DIEHARDave/LaneTag/docs/logo/3d/lanetag-logo-stacked-dark.obj

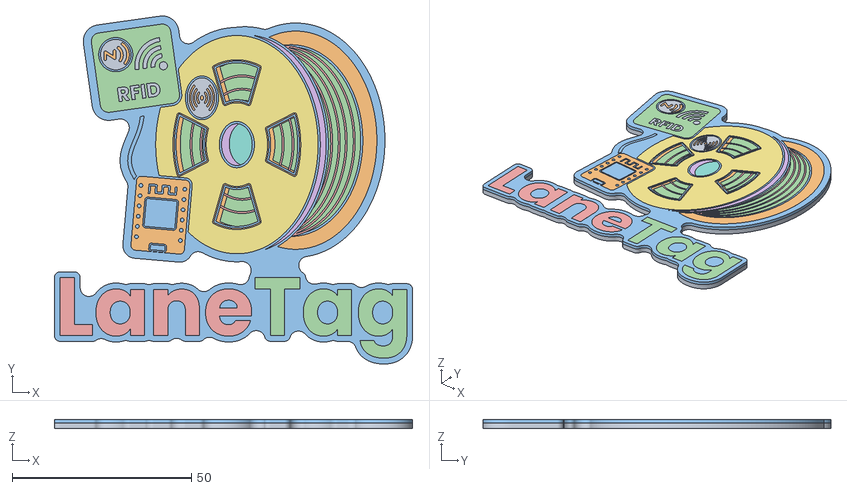
[picture p10: CAD file, 2026-11-13]
docs/logo/3d/lanetag-logo-stacked-dark.obj
100.0 x 97.1 x 2.60
base_plate
color_243241
color_1b2632
color_f28a1e
color_c9650f
color_53697f
color_3a4e63
color_141c25
color_ffffff
color_1e88e5
color_c8d0d8
color_d93a2f
color_eef2f6
