DIEHARDave/LaneTag/docs/logo/print/inlay-facedown/lanetag-icon-orange.stl

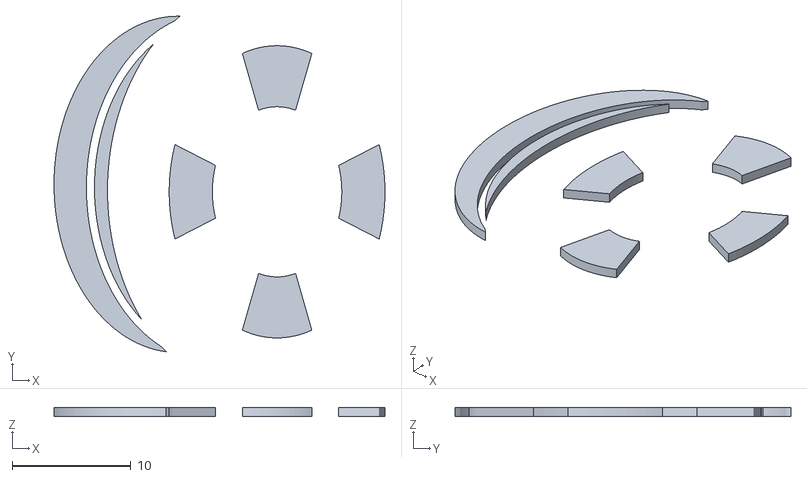
[picture p11: CAD file, 2026-11-13]
docs/logo/print/inlay-facedown/lanetag-icon-orange.stl
27.9 x 28.3 x 0.8
