DIEHARDave/LaneTag/docs/logo/print/inlay/lanetag-icon-white.stl

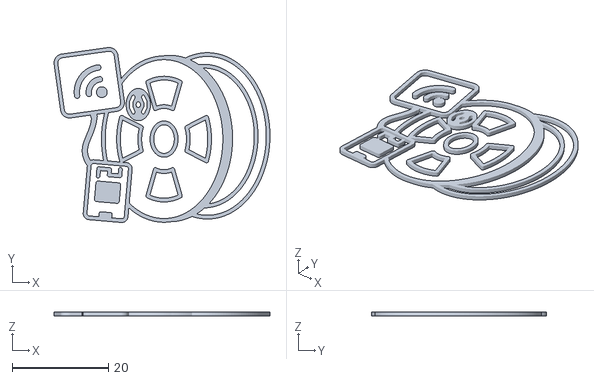
[picture p12: CAD file, 2026-11-13]
docs/logo/print/inlay/lanetag-icon-white.stl
45.0 x 36.5 x 0.8
