DIEHARDave/LaneTag/docs/logo/print/lanetag-logo-4color-B.obj

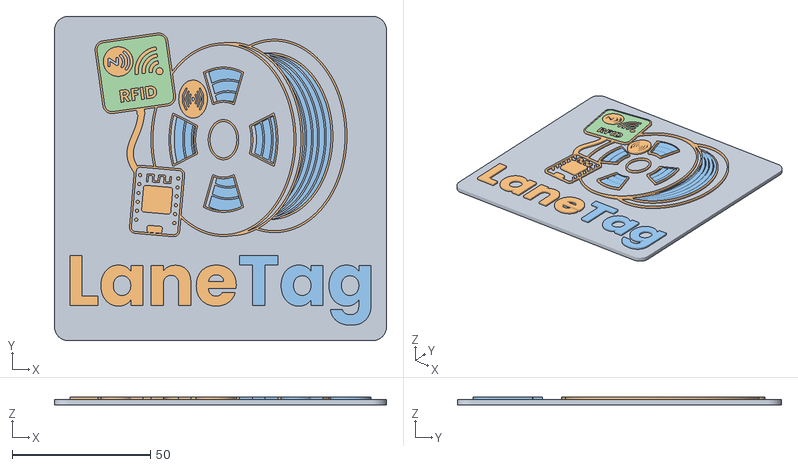
[picture p13: CAD file, 2026-11-13]
docs/logo/print/lanetag-logo-4color-B.obj
120.0 x 117.2 x 3.00
Plate_Black
Top_White
Top_Orange
Top_Red
