DIEHARDave/LaneTag/docs/logo/print/inlay-facedown/lanetag-text-white.stl

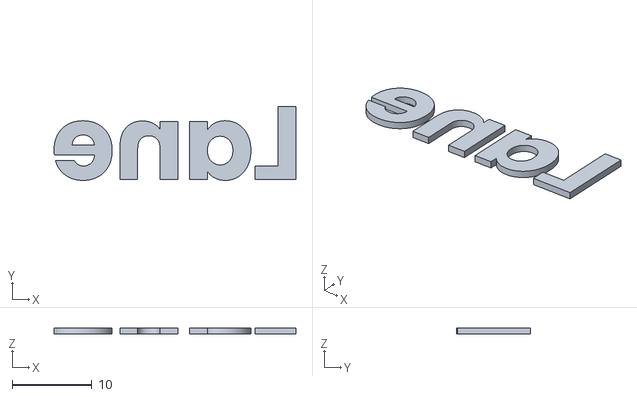
[picture p14: CAD file, 2026-11-13]
docs/logo/print/inlay-facedown/lanetag-text-white.stl
30.4 x 9.27 x 0.8
