DIEHARDave/LaneTag/docs/logo/print/lanetag-text-inlay-facedown.obj

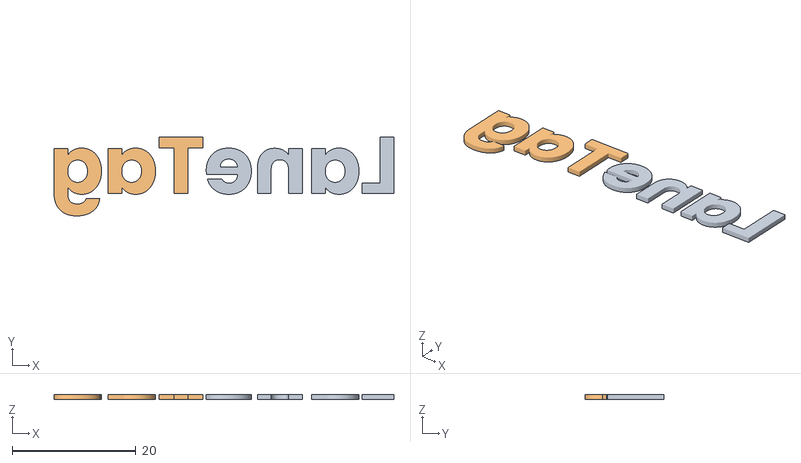
[picture p15: CAD file, 2026-11-13]
docs/logo/print/lanetag-text-inlay-facedown.obj
55.0 x 12.8 x 0.8
TextFD_White
TextFD_Orange
