DIEHARDave/LaneTag/docs/logo/print/inlay-facedown/lanetag-icon-red.stl

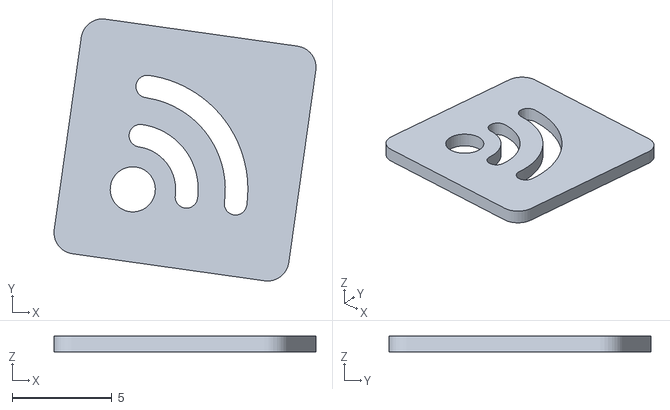
[picture p16: CAD file, 2026-11-13]
docs/logo/print/inlay-facedown/lanetag-icon-red.stl
13.1 x 13.1 x 0.8
