DIEHARDave/LaneTag/docs/logo/print/lanetag-icon-inlay-facedown.obj

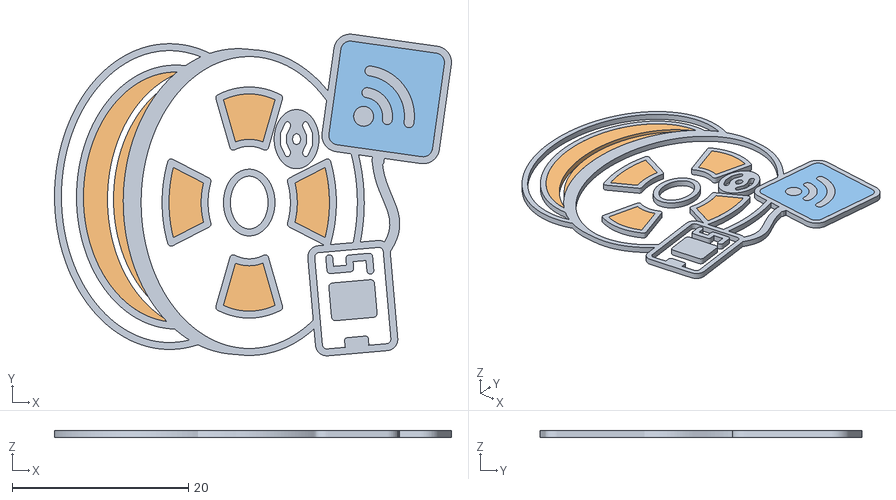
[picture p17: CAD file, 2026-11-13]
docs/logo/print/lanetag-icon-inlay-facedown.obj
45.0 x 36.5 x 0.8
IconFD_White
IconFD_Orange
IconFD_Red
