DIEHARDave/LaneTag/docs/logo/print/inlay/lanetag-text-orange.stl

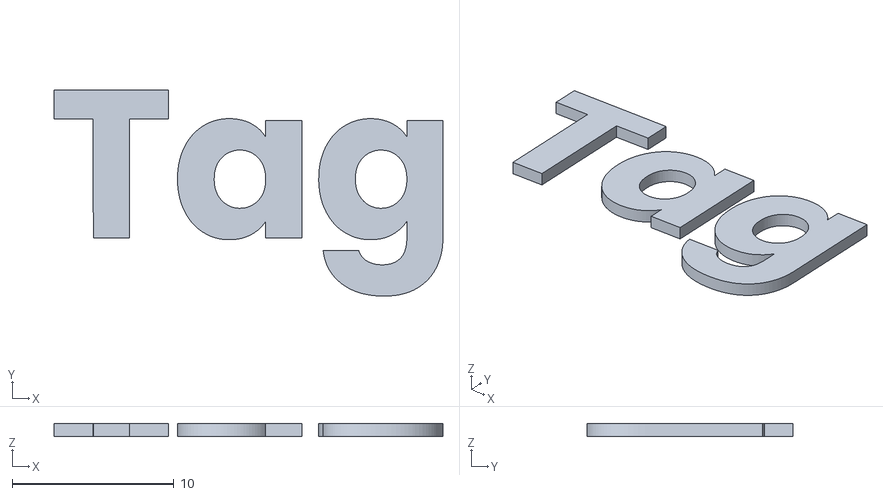
[picture p18: CAD file, 2026-11-13]
docs/logo/print/inlay/lanetag-text-orange.stl
24.1 x 12.8 x 0.8
