DIEHARDave/LaneTag/(list of files, cad)

Other CAD files:
docs/logo/print/inlay/lanetag-text-white.stl
docs/logo/print/inlay/lanetag-icon-orange.stl
docs/logo/print/inlay-facedown/lanetag-icon-white.stl
docs/logo/print/lanetag-icon-inlay.obj
docs/logo/print/inlay-facedown/lanetag-text-orange.stl
docs/logo/print/inlay/lanetag-icon-red.stl
docs/logo/print/lanetag-text-inlay.obj
docs/logo/3d/lanetag-logo-stacked-dark.blend
docs/logo/print/lanetag-inlays.blend
docs/logo/print/lanetag-logo-4color-B.blend
