DIEHARDave/LaneTag/src/display.cpp

#include "display.h"

#include <U8g2lib.h>
#include <WiFi.h>
#include <Wire.h>
#include <driver/gpio.h>
#include <esp_sleep.h>
#include <soc/soc_caps.h>

#include "app.h"
#include "lcd1602.h"
#include "tft.h"
#include "version.h"

namespace {

// The bus the display is on: Wire when it shares the PN532's pins (or the
// reader is not on I2C), else Wire1.
TwoWire *bus = nullptr;

// A scan stays on the screen this long (unless it waits for a slot).
constexpr uint32_t SCAN_SHOWN = 5 * 60 * 1000;
constexpr uint32_t SLOT_SHOWN = 3000;
constexpr uint32_t SPLASH_SHOWN = 3000;
constexpr uint32_t DRAW_INTERVAL = 200;
constexpr int WIDTH = 128;
// A title too long even in the smallest font scrolls: still for a moment,
// then two pixels per frame, round with a gap. Only the top 16 rows (two
// tile rows, 256 bytes) are sent for it.
constexpr uint32_t SCROLL_PAUSE = 2000, SCROLL_FRAME = 100;
constexpr int SCROLL_STEP = 2, SCROLL_GAP = 24, TITLE_BYTES = 256;
// On the LCD a row too long for it scrolls a character at a time.
constexpr uint32_t LCD_SCROLL_STEP = 350;
constexpr int LCD_SCROLL_GAP = 3;

const uint8_t *const SMALL = u8g2_font_5x7_tf;
const uint8_t *const MEDIUM = u8g2_font_6x10_tf;
const uint8_t *const LARGE = u8g2_font_helvB12_tf;
const uint8_t *const TITLE_SMALLER = u8g2_font_helvB10_tf;
const uint8_t *const HUGE_ = u8g2_font_helvB24_tf;
// Sized so the spool, "Lane" and the "Tag" box fit the 128 px OLED.
const uint8_t *const WORDMARK = u8g2_font_helvB14_tr;

// A spool side on, for the LCD's start-up screen: two flanges and the
// filament between them.
const uint8_t LCD_SPOOL[8] = {0b11111, 0b01110, 0b01110, 0b01110, 0b01110, 0b01110, 0b11111, 0b00000};

// The release part of the version: "v0.2.0-2" for "v0.2.0-2-g2d9f574-dirty".
String shortVersion() {
    String v = FIRMWARE_VERSION;
    int g = v.indexOf("-g");
    return g > 0 ? v.substring(0, g) : v;
}

uint8_t byteCallback(u8x8_t *u8x8, uint8_t msg, uint8_t count, void *data) {
    switch (msg) {
    case U8X8_MSG_BYTE_SEND: bus->write((uint8_t *)data, count); break;
    case U8X8_MSG_BYTE_START_TRANSFER: bus->beginTransmission(u8x8_GetI2CAddress(u8x8) >> 1); break;
    case U8X8_MSG_BYTE_END_TRANSFER: bus->endTransmission(); break;
    case U8X8_MSG_BYTE_INIT:
    case U8X8_MSG_BYTE_SET_DC: break;
    default: return 0;
    }
    return 1;
}

// The 16 characters of an LCD row shown now: the text itself when it fits,
// else a window scrolling round it (after a pause at the start).
String lcdFrame(const String &text, uint32_t since) {
    if ((int)text.length() <= Lcd1602::COLS) return text;
    String round = text + String("   ").substring(0, LCD_SCROLL_GAP);
    uint32_t span = round.length();
    uint32_t t = (millis() - since) % (SCROLL_PAUSE + span * LCD_SCROLL_STEP);
    int offset = t < SCROLL_PAUSE ? 0 : (t - SCROLL_PAUSE) / LCD_SCROLL_STEP;
    return (round + text).substring(offset, offset + Lcd1602::COLS);
}

// Left and right in one LCD row, the left cut to make room.
String lcdSplit(String left, const String &right) {
    int room = Lcd1602::COLS - right.length() - 1;
    if (room < 1) return right;
    if ((int)left.length() > room) left.remove(room);
    while ((int)left.length() < room + 1) left += ' ';
    return left + right;
}

struct NamedColor { const char *name; uint32_t rgb; };
const NamedColor COLOR_NAMES[] = {
    {"white", 0xFFFFFF}, {"black", 0x000000}, {"grey", 0x808080}, {"light grey", 0xC0C0C0},
    {"dark grey", 0x404040}, {"red", 0xE02020}, {"dark red", 0x801010}, {"orange", 0xFF8000},
    {"yellow", 0xFFE020}, {"gold", 0xC8A040}, {"beige", 0xE8D8B0}, {"brown", 0x804820},
    {"green", 0x20B040}, {"lime", 0xA0E040}, {"dark green", 0x105828}, {"teal", 0x109090},
    {"cyan", 0x40D8F0}, {"light blue", 0x80B8F0}, {"blue", 0x2050E0}, {"navy", 0x182868},
    {"purple", 0x7030B0}, {"violet", 0xB060F0}, {"magenta", 0xF030C0}, {"pink", 0xF8A0C0},
};

}  // namespace

// The nearest by the "redmean" distance.
const char *colorName(uint32_t color) {
    long r1 = (color >> 16) & 0xFF, g1 = (color >> 8) & 0xFF, b1 = color & 0xFF;
    const char *best = "";
    double bestDistance = 1e18;
    for (auto &c : COLOR_NAMES) {
        long r2 = (c.rgb >> 16) & 0xFF, g2 = (c.rgb >> 8) & 0xFF, b2 = c.rgb & 0xFF;
        double mean = (r1 + r2) / 2.0;
        double d = (2 + mean / 256) * (r1 - r2) * (r1 - r2) + 4 * (g1 - g2) * (g1 - g2) +
                   (2 + (255 - mean) / 256) * (b1 - b2) * (b1 - b2);
        if (d < bestDistance) {
            bestDistance = d;
            best = c.name;
        }
    }
    return best;
}

const char *displayTypeName(DisplayType type) {
    switch (type) {
    case DisplayType::SSD1306: return "ssd1306";
    case DisplayType::SH1106: return "sh1106";
    case DisplayType::CydIli9341: return "cyd";
    case DisplayType::CydSt7789: return "cyd-st7789";
    case DisplayType::C6Lcd147: return "c6-lcd147";
    case DisplayType::Lcd19: return "lcd19";
    case DisplayType::Lcd114: return "lcd114";
    case DisplayType::Lcd169: return "c6-lcd169";
    case DisplayType::Lcd1602: return "lcd1602";
    default: return "none";
    }
}

void Display::begin(const DisplayConfig &config, const ReaderPins &reader) {
    if (config.type == DisplayType::None) return;
    if (isTft(config.type)) {
#ifdef HAS_TFT
        tft_ = new Tft();
        tft_->begin(config);
#else
        error_ = "this firmware has no touch screen support";
#endif
        return;
    }
    if (config.sda < 0 || config.scl < 0) {
        error_ = "the display needs its SDA and SCL pins";
        return;
    }
    bool readerI2C = reader.chip == ReaderChip::PN532 && reader.bus == Pn532Bus::I2C;
    // The LCD's PCF8574 is a 100 kHz part.
    uint32_t clock = config.type == DisplayType::Lcd1602 ? 100000 : 400000;
    if (readerI2C && reader.sda == config.sda && reader.scl == config.scl) {
        // Already started by the PN532 (at 100 kHz, which all are fine with).
        bus = &Wire;
    } else if (!readerI2C) {
        bus = &Wire;
        bus->begin(config.sda, config.scl, clock);
    } else {
#if SOC_I2C_NUM > 1
        bus = &Wire1;
        bus->begin(config.sda, config.scl, clock);
#else
        error_ = "this chip has one I2C bus: put the display on the reader's SDA and SCL pins";
        return;
#endif
    }
    bus->beginTransmission(config.address);
    if (bus->endTransmission() != 0) {
        char text[160];
        int n = snprintf(text, sizeof(text), "no display answering at 0x%02X (SDA %d, SCL %d)", config.address,
                         config.sda, config.scl);
        // What does answer, to tell a wrong address from a wiring fault.
        String found;
        for (uint8_t address = 0x08; address <= 0x77; address++) {
            bus->beginTransmission(address);
            if (bus->endTransmission() == 0) found += (found.length() ? ", 0x" : "0x") + String(address, HEX);
        }
        if (found.length())
            snprintf(text + n, sizeof(text) - n, "; found %s on these pins", found.c_str());
        else if (!gpio_get_level((gpio_num_t)config.sda) || !gpio_get_level((gpio_num_t)config.scl))
            snprintf(text + n, sizeof(text) - n, "; %s is held low (wiring or power)",
                     !gpio_get_level((gpio_num_t)config.sda) ? "SDA" : "SCL");
        else
            snprintf(text + n, sizeof(text) - n, "; nothing answers on these pins (check VCC, GND, SDA/SCL swap)");
        error_ = text;
        log_w("%s", text);
        return;
    }
    sleepMinutes_ = config.sleepMinutes;
    changedAt_ = millis();
    // Not when woken from deep sleep: then the button was pressed to scan.
    bool bootLogo = config.bootLogo && esp_sleep_get_wakeup_cause() == ESP_SLEEP_WAKEUP_UNDEFINED;
    if (config.type == DisplayType::Lcd1602) {
        lcd_ = new Lcd1602();
        lcd_->begin(bus, config.address);
        bootLogo ? splash() : draw(true);
        return;
    }
    u8g2_ = new U8G2();
    const u8g2_cb_t *rotation = config.flip ? U8G2_R2 : U8G2_R0;
    if (config.type == DisplayType::SH1106)
        u8g2_Setup_sh1106_i2c_128x64_noname_f(u8g2_->getU8g2(), rotation, byteCallback, u8x8_gpio_and_delay_arduino);
    else
        u8g2_Setup_ssd1306_i2c_128x64_noname_f(u8g2_->getU8g2(), rotation, byteCallback, u8x8_gpio_and_delay_arduino);
    u8g2_->setI2CAddress(config.address << 1);
    u8g2_->begin();
    u8g2_->enableUTF8Print();
    memset(shown_, 0xFF, sizeof(shown_));
    bootLogo ? splash() : draw(true);
}

void Display::splash() {
    splashUntil_ = millis() + SPLASH_SHOWN;
    if (lcd_) {
        lcd_->glyph(1, LCD_SPOOL);
        lcd_->row(0, "   LaneTag ");
        String version = shortVersion().substring(0, Lcd1602::COLS);
        lcd_->row(1, String("        ").substring(0, (Lcd1602::COLS - version.length()) / 2) + version);
        lcdShown_[0] = lcdShown_[1] = "";
        return;
    }
    // A spool face, then "Lane" and "Tag" white on black (the logo's
    // orange part), in the middle; the version under them.
    u8g2_->clearBuffer();
    u8g2_->setFont(WORDMARK);
    int lane = u8g2_->getStrWidth("Lane"), tag = u8g2_->getStrWidth("Tag");
    constexpr int R = 11, GAP = 5, PAD = 3, CY = 28;
    int x = (WIDTH - (2 * R + 1 + GAP + lane + 1 + tag + 2 * PAD)) / 2;
    if (x < 0) x = 0;
    int cx = x + R;
    u8g2_->drawCircle(cx, CY, R);
    u8g2_->drawDisc(cx, CY, R - 3);
    u8g2_->setDrawColor(0);
    u8g2_->drawDisc(cx, CY, 4);
    u8g2_->setDrawColor(1);
    u8g2_->drawCircle(cx, CY, 4);
    u8g2_->drawDisc(cx, CY, 1);
    x += 2 * R + 1 + GAP;
    u8g2_->drawStr(x, CY + 7, "Lane");
    x += lane + 1;
    u8g2_->drawRBox(x, CY - 10, tag + 2 * PAD, 22, 3);
    u8g2_->setDrawColor(0);
    u8g2_->drawStr(x + PAD, CY + 7, "Tag");
    u8g2_->setDrawColor(1);
    u8g2_->setFont(SMALL);
    String version = shortVersion();
    u8g2_->drawStr((WIDTH - u8g2_->getStrWidth(version.c_str())) / 2, 63, version.c_str());
    u8g2_->sendBuffer();
    memset(shown_, 0xFF, sizeof(shown_));
}

String Display::error() const {
    if (lcd_ && lcd_->errors())
        return "the LCD missed " + String(lcd_->errors()) + " writes: check its SDA/SCL wiring and pull-ups";
    return error_;
}

void Display::refresh() {
#ifdef HAS_TFT
    if (tft_) return tft_->refresh();
#endif
    draw(true);
}

void Display::showSlot() {
#ifdef HAS_TFT
    if (tft_) return tft_->showSlot();
#endif
    slotUntil_ = millis() + SLOT_SHOWN;
    wake();
    draw(true);
}

void Display::wake() {
#ifdef HAS_TFT
    if (tft_) return tft_->wake();
#endif
    changedAt_ = millis();
    if (asleep_ && u8g2_) {
        u8g2_->setPowerSave(0);
        asleep_ = false;
    }
    if (asleep_ && lcd_) {
        lcd_->power(true);
        asleep_ = false;
    }
}

void Display::off() {
#ifdef HAS_TFT
    if (tft_) return tft_->off();
#endif
    if (u8g2_) u8g2_->setPowerSave(1);
    if (lcd_) lcd_->power(false);
    asleep_ = true;
}

void Display::loop() {
#ifdef HAS_TFT
    if (tft_) return tft_->loop();
#endif
    if ((!u8g2_ && !lcd_) || millis() - lastDraw_ < (scrolling_ ? SCROLL_FRAME : DRAW_INTERVAL)) return;
    draw(false);
}

void Display::draw(bool force) {
    if (splashUntil_) {
        if (!force && (int32_t)(millis() - splashUntil_) < 0) return;
        splashUntil_ = 0;
        force = true;
    }
    if (lcd_) return drawLcd(force);
    if (!u8g2_) return;
    lastDraw_ = millis();
    u8g2_->clearBuffer();
    scrolling_ = false;
    render();
    // Send only a changed picture: a full frame takes 25-100 ms on I2C.
    uint8_t *buffer = u8g2_->getBufferPtr();
    if (force || title_ != shownTitle_ ||
        memcmp(buffer + TITLE_BYTES, shown_ + TITLE_BYTES, sizeof(shown_) - TITLE_BYTES) != 0 ||
        (!scrolling_ && memcmp(buffer, shown_, TITLE_BYTES) != 0)) {
        memcpy(shown_, buffer, sizeof(shown_));
        shownTitle_ = title_;
        wake();
        u8g2_->sendBuffer();
        return;
    }
    // Only the scrolling title moved: no wake-up, and only its rows.
    if (scrolling_ && !asleep_ && memcmp(buffer, shown_, TITLE_BYTES) != 0) {
        memcpy(shown_, buffer, TITLE_BYTES);
        u8g2_->updateDisplayArea(0, 0, WIDTH / 8, 2);
    }
    // The same picture for a long time: switch off (OLEDs burn in).
    if (!asleep_ && sleepMinutes_ > 0 && millis() - changedAt_ > (uint32_t)sleepMinutes_ * 60000) {
        u8g2_->setPowerSave(1);
        asleep_ = true;
    }
}

void Display::render() {
    if ((int32_t)(millis() - slotUntil_) < 0) return renderSlot();
    if (app.apMode) return renderSetup();
    const ScanRecord &last = app.last;
    if (last.id && (last.waiting || millis() - last.at < SCAN_SHOWN)) return renderScan();
    renderIdle();
}

// Printer and slot, under a line at the bottom.
void Display::footer() {
    const PrinterConfig *printer = app.config.activePrinter();
    u8g2_->drawHLine(0, 53, WIDTH);
    u8g2_->setFont(MEDIUM);
    if (!printer) {
        u8g2_->drawUTF8(0, 63, "No printer");
        return;
    }
    String slot = printer->hasSlots() ? slotName(*printer, printer->slot) : String();
    int slotWidth = slot.length() ? u8g2_->getUTF8Width(slot.c_str()) : -6;
    if (slot.length()) u8g2_->drawUTF8(WIDTH - slotWidth, 63, slot.c_str());
    String name = printer->name;
    while (name.length() > 1 && u8g2_->getUTF8Width(name.c_str()) > WIDTH - slotWidth - 6)
        name.remove(name.length() - 1);
    u8g2_->drawUTF8(0, 63, name.c_str());
}

// One line in the top 16 rows (yellow on two-color OLEDs), in the largest
// font it fits; scrolling when it fits none.
void Display::title(const String &text) {
    if (text != title_) scrollStart_ = millis();
    title_ = text;
    for (const uint8_t *font : {LARGE, TITLE_SMALLER, MEDIUM}) {
        u8g2_->setFont(font);
        if (u8g2_->getUTF8Width(text.c_str()) <= WIDTH) {
            u8g2_->drawUTF8(0, 12, text.c_str());
            return;
        }
    }
    scrolling_ = true;
    int span = u8g2_->getUTF8Width(text.c_str()) + SCROLL_GAP;
    uint32_t frames = span / SCROLL_STEP;
    uint32_t t = (millis() - scrollStart_) % (SCROLL_PAUSE + frames * SCROLL_FRAME);
    int offset = t < SCROLL_PAUSE ? 0 : (t - SCROLL_PAUSE) / SCROLL_FRAME * SCROLL_STEP;
    // Clipped to the title rows, so nothing lands on the line below.
    u8g2_->setClipWindow(0, 0, WIDTH - 1, 15);
    u8g2_->drawUTF8(-offset, 12, text.c_str());
    u8g2_->drawUTF8(span - offset, 12, text.c_str());
    u8g2_->setMaxClipWindow();
}

int Display::wrap(const String &text, int y, int maxLines) {
    u8g2_->setFont(SMALL);
    int start = 0, lines = 0;
    while (start < (int)text.length() && lines < maxLines) {
        // The longest run of whole words that fits.
        int end = start, fit = -1;
        while (end <= (int)text.length()) {
            if (end == (int)text.length() || text[end] == ' ') {
                if (u8g2_->getUTF8Width(text.substring(start, end).c_str()) > WIDTH) break;
                fit = end;
                if (end == (int)text.length()) break;
            }
            end++;
        }
        if (fit < 0) {
            // One word wider than the screen: cut it.
            fit = start + 1;
            while (fit < (int)text.length() && u8g2_->getUTF8Width(text.substring(start, fit + 1).c_str()) <= WIDTH)
                fit++;
        }
        String line = text.substring(start, fit);
        if (lines == maxLines - 1 && fit < (int)text.length()) {
            while (line.length() && u8g2_->getUTF8Width((line + "...").c_str()) > WIDTH) line.remove(line.length() - 1);
            line += "...";
        }
        y += 8;
        u8g2_->drawUTF8(0, y, line.c_str());
        lines++;
        start = fit;
        while (start < (int)text.length() && text[start] == ' ') start++;
    }
    return y;
}

void Display::renderSlot() {
    const PrinterConfig *printer = app.config.activePrinter();
    if (!printer) return title("No printer");
    title(printer->name);
    if (!printer->hasSlots()) return;
    u8g2_->setFont(SMALL);
    u8g2_->drawUTF8(0, 25, printer->slot ? "Scans go to" : "Scans ask for the slot");
    u8g2_->setFont(HUGE_);
    String slot = slotName(*printer, printer->slot);
    u8g2_->drawUTF8((WIDTH - u8g2_->getUTF8Width(slot.c_str())) / 2, 58, slot.c_str());
}

void Display::renderSetup() {
    title("Wi-Fi setup");
    u8g2_->setFont(SMALL);
    u8g2_->drawUTF8(0, 25, ("Join " + app.apName).c_str());
    u8g2_->drawUTF8(0, 34, "password lanetag1");
    u8g2_->drawUTF8(0, 43, ("open " + WiFi.softAPIP().toString()).c_str());
    if (app.wifiError.length()) wrap(app.wifiError, 44, 2);
}

void Display::renderIdle() {
    footer();
    if (!app.reader.connected()) {
        title("No reader");
        wrap(app.reader.error(), 17, 4);
        return;
    }
    title("Ready");
    u8g2_->setFont(SMALL);
    u8g2_->drawUTF8(0, 27, "Hold a spool to the reader");
    String address = WiFi.status() == WL_CONNECTED ? WiFi.localIP().toString() : String("Wi-Fi lost");
    u8g2_->drawUTF8(0, 40, address.c_str());
}

// The filament of the last scan and how it went:
//   PLA Silk                 (material; the yellow band)
//   Polymaker        #19     (brand, Spoolman spool)
//   orange FF8000  220C      (color, nozzle)
//   Assigned to ...          (status, small)
//   -----------------
//   AD5X-1          Slot 1   (printer and slot)
void Display::renderScan() {
    footer();
    String name, brand, detail, status;
    int spool;
    scanText(name, brand, detail, status, spool);
    title(name);

    int y = 15;
    u8g2_->setFont(MEDIUM);
    int spoolWidth = 0;
    if (spool) {
        String id = "#" + String(spool);
        spoolWidth = u8g2_->getUTF8Width(id.c_str()) + 4;
        u8g2_->drawUTF8(WIDTH - spoolWidth + 4, 25, id.c_str());
    }
    while (brand.length() > 1 && u8g2_->getUTF8Width(brand.c_str()) > WIDTH - spoolWidth) brand.remove(brand.length() - 1);
    if (brand.length() || spool) {
        u8g2_->drawUTF8(0, 25, brand.c_str());
        y = 25;
    }
    if (detail.length()) {
        y += 10;
        u8g2_->drawUTF8(0, y, detail.c_str());
    }
    // Status lines end above the footer line (y 53).
    wrap(status, y, (51 - y) / 8);
}

void Display::scanText(String &name, String &brand, String &detail, String &status, int &spool) {
    const ScanRecord &last = app.last;
    const Filament &f = last.filament;
    if (f.hasFilamentData()) {
        name = f.material;
        if (f.modifiers.length()) name += " " + f.modifiers;
        brand = f.brand.length() ? f.brand : f.name;
        if (f.color >= 0) detail = String(colorName(f.color)) + " " + f.colorHex();
        int nozzle = f.nozzleTemp();
        if (nozzle) detail += (detail.length() ? "  " : "") + String(nozzle) + "°" "C";
    } else if (last.printerTitle.length()) {
        // FF_NFC decodes formats the reader does not know.
        name = last.printerTitle;
    } else {
        name = f.spoolId ? "Spool tag" : "Unknown tag";
        brand = tagKindName(last.tag.kind);
    }
    if (!name.length()) name = last.printerTitle;
    if (last.printerSpool && last.printerTitle.length()) {
        // The printer found the spool (in Spoolman): its name, not the tag's,
        // with the vendor it starts with on the brand line.
        name = last.printerTitle;
        brand = "";
        int n = f.brand.length();
        if (n && name.length() > (unsigned)n + 1 && name[n] == ' ' && name.substring(0, n).equalsIgnoreCase(f.brand)) {
            brand = name.substring(0, n);
            name = name.substring(n + 1);
        }
    }
    spool = last.printerSpool ? last.printerSpool : f.spoolId;
    status = last.status;
    if (last.waiting && last.printer >= 0 && last.printer < (int)app.config.printers.size())
        status = app.config.printers[last.printer].method == Method::FfNfc ? "Pick the slot on the printer's screen"
                                                                             : "Pick a slot on the web page";
    if (!last.ok && status.length()) status = "! " + status;
}

// Only rows that changed go to the LCD: each character is four I2C bytes.
void Display::drawLcd(bool force) {
    lastDraw_ = millis();
    scrolling_ = false;
    String rows[2];
    renderLcd(rows);
    bool changed = force;
    for (int r = 0; r < 2; r++) {
        String text = Lcd1602::toLcd(rows[r]);
        if (text != lcdText_[r]) {
            lcdText_[r] = text;
            lcdSince_[r] = millis();
            changed = true;
        }
    }
    if (changed) wake();
    if (asleep_) return;
    for (int r = 0; r < 2; r++) {
        String frame = lcdFrame(lcdText_[r], lcdSince_[r]);
        if (force || frame != lcdShown_[r]) {
            lcd_->row(r, frame);
            lcdShown_[r] = frame;
        }
    }
    // LCDs do not burn in, but a backlight left on all day is a waste.
    if (sleepMinutes_ > 0 && millis() - changedAt_ > (uint32_t)sleepMinutes_ * 60000) {
        lcd_->power(false);
        asleep_ = true;
    }
}

// The OLED's screens in two rows of 16 characters; longer rows scroll.
void Display::renderLcd(String rows[2]) {
    const PrinterConfig *printer = app.config.activePrinter();
    if ((int32_t)(millis() - slotUntil_) < 0) {
        rows[0] = printer ? printer->name : String("No printer");
        if (printer && printer->hasSlots()) rows[1] = printer->slot ? "Scans -> " + slotName(*printer, printer->slot) : String("Scans ask for the slot");
        return;
    }
    if (app.apMode) {
        rows[0] = "Wi-Fi setup";
        rows[1] = "Join " + app.apName + ", password lanetag1, open " + WiFi.softAPIP().toString();
        if (app.wifiError.length()) rows[1] += ". " + app.wifiError;
        return;
    }
    const ScanRecord &last = app.last;
    if (last.id && (last.waiting || millis() - last.at < SCAN_SHOWN)) {
        String name, brand, detail, status;
        int spool;
        scanText(name, brand, detail, status, spool);
        // The spool number on the right, or after a name too long for both.
        rows[0] = name;
        String id = "#" + String(spool);
        if (spool) rows[0] = (int)(name.length() + id.length()) < Lcd1602::COLS ? lcdSplit(name, id) : name + " " + id;
        if (!last.ok || last.waiting) {
            rows[1] = status;
        } else {
            for (const String *part : {&brand, &detail, &status})
                if (part->length()) rows[1] += (rows[1].length() ? "  " : "") + *part;
        }
        return;
    }
    if (!app.reader.connected()) {
        rows[0] = "No reader";
        rows[1] = app.reader.error();
        return;
    }
    rows[0] = !printer             ? String("No printer")
              : printer->hasSlots() ? lcdSplit(printer->name, slotName(*printer, printer->slot))
                                    : printer->name;
    rows[1] = WiFi.status() == WL_CONNECTED ? WiFi.localIP().toString() : String("Wi-Fi lost");
}
