DIEHARDave/LaneTag/src/display.h

// An optional screen: a 128x64 I2C OLED (SSD1306 or SH1106), a 16x2 I2C
// character LCD (lcd1602.h), the 2.8"
// touch screen of the ESP32-2432S028 or the 1.47" one of the Waveshare
// ESP32-C6-LCD-1.47 (see tft.h). It shows the active
// printer and its slot, the filament of the last scan and what the printer
// made of it.
#pragma once

#include <Arduino.h>

#include "reader.h"

enum class DisplayType : uint8_t { None = 0, SSD1306 = 1, SH1106 = 2, CydIli9341 = 3, CydSt7789 = 4, C6Lcd147 = 5, Lcd1602 = 6, Lcd19 = 7, Lcd114 = 8, Lcd169 = 9 };

inline bool isTft(DisplayType type) {
    return type == DisplayType::CydIli9341 || type == DisplayType::CydSt7789 || type == DisplayType::C6Lcd147 ||
           type == DisplayType::Lcd19 || type == DisplayType::Lcd114 ||
           type == DisplayType::Lcd169;
}

struct DisplayConfig {
    DisplayType type = DisplayType::None;
    int sda = -1, scl = -1;     // OLED
    uint8_t address = 0x3C;     // 7-bit; 0x3D on some modules; LCDs 0x27 or 0x3F
    bool flip = false;          // turned 180 degrees (not the LCD)
    int sleepMinutes = 10;      // screen off after this long without a change; 0: never
    bool bootLogo = true;       // the logo (TFT) or name (OLED, LCD) for a few seconds at power-on
};

const char *displayTypeName(DisplayType type);
// A color name for the screen: the nearest of a few common filament
// colors.
const char *colorName(uint32_t color);

class Display {
public:
    // After the reader's begin(), so a display on the reader's I2C pins
    // shares its bus.
    void begin(const DisplayConfig &config, const ReaderPins &reader);
    // Redraws when something changed; cheap to call every loop.
    void loop();
    // Draw now (before a call that blocks the loop, such as a scan going
    // to the printer).
    void refresh();
    // Show the active printer's slot in large type for a few seconds.
    void showSlot();
    // Wake the screen.
    void wake();
    // Screen off (before deep sleep).
    void off();

    bool enabled() const { return u8g2_ != nullptr || tft_ != nullptr || lcd_ != nullptr; }
    String error() const;

private:
    void draw(bool force);
    // "LaneTag" and the version, until splashUntil_ (or a scan).
    void splash();
    void drawLcd(bool force);
    void renderLcd(String rows[2]);
    void render();
    void renderSlot();
    void renderSetup();
    void renderScan();
    void renderIdle();
    // What the last scan found, for both kinds of screen.
    void scanText(String &name, String &brand, String &detail, String &status, int &spool);
    void footer();
    void title(const String &text);
    // Word-wrapped text in the small font; returns the y after the last line.
    int wrap(const String &text, int y, int maxLines);

    class U8G2 *u8g2_ = nullptr;
    class Tft *tft_ = nullptr;
    class Lcd1602 *lcd_ = nullptr;
    // The LCD's two rows: their full text, when it last changed, and what
    // the LCD shows now.
    String lcdText_[2], lcdShown_[2];
    uint32_t lcdSince_[2] = {0, 0};
    String error_;
    uint8_t shown_[1024];
    String title_, shownTitle_;     // the title drawn now, and when last really changed
    bool scrolling_ = false;        // the title is too long and scrolls
    uint32_t scrollStart_ = 0;
    bool asleep_ = false;
    uint32_t changedAt_ = 0, lastDraw_ = 0, slotUntil_ = 0;
    uint32_t splashUntil_ = 0;      // 0: no start-up screen showing
    int sleepMinutes_ = 0;
};
