DIEHARDave/LaneTag/src/tft.h

// The 2.8" 320x240 touch screen of the ESP32-2432S028 ("Cheap Yellow
// Display"): ILI9341 (or ST7789 on the two-USB version) on HSPI, XPT2046
// touch on its own pins. Besides what the OLED shows, it has the filament's
// color and buttons: the header picks the printer, the bottom row the
// fixed slot, and a scan waiting for a slot can be put into one here.
// Also the 1.47" 320x172 ST7789 of the Waveshare ESP32-C6-LCD-1.47: the
// same screens, tighter and without touch; and the JD9853 of the
// ESP32-C6-Touch-LCD-1.47, the same with touch.
#pragma once

#ifdef HAS_TFT

#include <Arduino.h>

#include "display.h"

namespace lgfx {
inline namespace v1 {
class LGFX_Sprite;
}
}  // namespace lgfx

class Tft {
public:
    void begin(const DisplayConfig &config);
    void loop();
    void refresh() { draw(true); }
    void showSlot() { wake(); draw(true); }
    void wake();
    void off();

private:
    enum class Screen : uint8_t { Setup, NoReader, Idle, Scan };

    void draw(bool force);
    // The full logo and the version, until splashUntil_ (or a touch or scan).
    void drawSplash();
    // What is on the screen, as text: redraw only when it changes.
    String contents(Screen screen) const;
    Screen current() const;
    void drawHeader();
    void drawSlots();
    void drawVoice();
    void drawSetup();
    void drawNoReader();
    void drawIdle();
    void drawScan();
    // Word-wrapped text in the current font; returns the y below it.
    int wrap(const String &text, int x, int y, int width, int maxLines);
    void touched(int x, int y);
    bool readTouch(int &x, int &y);
    int slotWidth() const { return (w_ - 2 * corner_) / 5; }    // Ask, 1-4
    // The buttons for a scan waiting for a slot: on a short screen, where
    // the slot row would be.
    int pickY() const { return compact_ ? footer_ + 2 : 146; }
    int pickH() const { return compact_ ? h_ - footer_ - 4 : 42; }
    // Four across (74 on a 320 wide screen).
    int pickW() const { return (w_ - 16 - 2 * corner_) / 4 - 2; }
    bool startScroll(const String &text, int x, int y, int width, uint32_t color = 0xFFFFFFu);
    void drawScroll();

    class CydLcd *lcd_ = nullptr;
    lgfx::LGFX_Sprite *sprite_ = nullptr;       // the scrolling name, drawn off screen
    String scrollText_;
    bool scrolling_ = false;
    int scrollX_ = 0, scrollY_ = 0;
    uint32_t scrollStart_ = 0, lastScroll_ = 0;
    String shown_;
    int w_ = 320, h_ = 240;
    int header_ = 40, footer_ = 192;            // footer: top of the slot buttons
    bool compact_ = false;                      // 172 high: tighter rows
    bool tiny_ = false;                         // 135 high: smaller still
    int margin() const { return tiny_ ? 6 : 14; }  // left edge of the text
    int corner_ = 0;                            // inset from rounded screen corners
    bool touch_ = true;
    bool flip_ = false;
    bool asleep_ = false;
    bool touchDown_ = false;
    uint32_t changedAt_ = 0, lastDraw_ = 0, lastTouch_ = 0;
    uint32_t splashUntil_ = 0;                  // 0: no logo on the screen
    int sleepMinutes_ = 0;
};

#endif
