DIEHARDave/LaneTag/(commit log)

2026-10-19 zmod_esp32-nfc: ESP32 + PN532 Wi-Fi tag reader for AD5X and Creator 5
    Reads NTAG, MIFARE Classic (Bambu, Creality, Snapmaker keys derived from
    the UID) and Type 4 tags with a PN532 over I2C or HSU, and sends each
    scan to the printer chosen on the device's web page:
    - Zmod + zmod_nfc: the raw read goes to the plugin's network listener,
    which decodes it, looks it up in Spoolman, shows its slot prompt and
    fills lane_data, as for a USB reader on the printer
    - Zmod basic: CHANGE_ZCOLOR through Moonraker plus lane_data
    - Stock firmware: msConfig_cmd on the local API (Creator 5 palette and
    materials)
    Web page for Wi-Fi (setup access point and captive portal), printers,
    reader pins, slot pic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
    [app.h, config.cpp, config.h, decoders.cpp, decoders.h, feedback.cpp, feedback.h, keys.cpp]
2026-10-19 Reach zmod_nfc through Moonraker instead of a listener of its own
    zmod_nfc now registers Klipper endpoints (zmod_nfc/scan, assign, cancel,
    info), which Moonraker publishes on its HTTP API, so the printer needs no
    extra port or server. A scan is accepted at once and its outcome read
    from printer.zmod_nfc.remote. The per-printer token becomes an optional
    Moonraker API key, used by both Zmod methods.
2026-10-20 zmod_nfc endpoints are under /printer/ on Moonraker
    Moonraker publishes Klipper endpoints with a /printer/ prefix
    (/printer/zmod_nfc/scan); found testing against the Creator 5.
2026-10-20 Fixed slot per reader, Wi-Fi power setting, hardware bring-up fixes
    - Each printer entry can fix the reader to one slot or toolhead (one
    reader per IFS slot): scans go straight into it without a prompt. For
    zmod_nfc the slot travels with the scan; the global auto slot setting is
    gone (old settings migrate).
    - Wi-Fi transmit power setting, applied at once. The ESP32-C3 default is
    now 15 dBm: 8.5 dBm lost 80-90% of packets on a SuperMini that worked
    without loss from 11 to 19.5 dBm.
    - PN532 over I2C: poll readiness through the HAL so a busy chip's NAKs
    are not logged as errors; retry failed NTAG page reads; list the I2C
    devices found when no PN532 answers.
    - Wi-Fi: say why the ho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
    [app.h, config.cpp, config.h, main.cpp, pn532.cpp, printers.cpp, printers.h]
2026-10-20 Stock screens: snap colours to each model's palette by CIEDE2000
    The AD5X's stock screen, like the Creator 5's, only draws its own 24
    colours, stored as "#RRGGBB"; any other colour was stored but not shown.
    The AD5X palette comes from its firmwareExe (3.1.7). Both models now pick
    the closest entry by CIEDE2000: plain CIELAB distance turned saturated
    blues purple (#0022FF became "bright purple"). The status says when a
    colour was snapped.
    README: a "What your printer needs" section - stock printers work with
    no modding (material and colour only), Zmod adds lane data, zmod_nfc and
    zmod_afclite are optional extras. Status: AD5X with zmod_nfc and the
    AD5X stock screen tested.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
    [printers.cpp]
2026-10-20 Make clear that stock and Zmod basic printers cannot ask for the slot
    Only zmod_nfc can show a slot popup on the printer's screen. For the
    other methods the slot option reads "Ask on this web page", with a
    warning that nothing is sent to the printer until the slot is picked on
    the reader's page, which then has to be open in a browser. Switching a
    printer to stock or Zmod basic picks slot 1 instead of asking. The Scan
    tab and the README say the same.
2026-10-20 Add RC522 and PN5180 readers, ISO 15693 tags and OpenPrintTag decoding
    Readers sit behind a common NfcChip interface; the chip is picked under
    Settings > NFC reader.
    - RC522 (MFRC522) over SPI: WUPA/anticollision/select, MIFARE Classic
    through MFAuthent, NTAG/Ultralight reads.
    - PN5180 over SPI with BUSY: ISO 14443A as above, plus ISO 15693
    inventory and block reads, sent to zmod_nfc as tag kind type5.
    - Shared software ISO-DEP (RATS, I-blocks, chaining, WTX) for Type 4
    tags on both, since neither chip does it itself.
    - OpenPrintTag decoder (minimal CBOR) on the device, so the stock and
    Zmod basic methods get material and colour from these tags too.
    Matches zmod_nfc on its six Ope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
2026-10-20 Slot button, and picking the slot or Ask on the Scan tab
    The board's BOOT button (Settings > Slot button pin) steps the active
    printer's fixed slot through ask, 1..4: a first press blinks the current
    slot on the LED, presses within 5 s move on. The Scan tab outlines the slot
    the next scan goes into; clicking a slot or the new Ask tile sets it
    (POST /api/fixed_slot), except while a scan waits for its slot.
    [config.cpp, config.h, feedback.cpp, feedback.h, main.cpp, web.cpp]
2026-10-21 Fail fast on a stuck I2C bus; keep retrying Wi-Fi from setup mode
    A PN532 or wire holding SDA/SCL low made every I2C transfer wait for its
    timeout, and the bus scan in the error message then took minutes, so the
    web page stopped answering. Check the idle lines before init, clock out
    a device stuck mid-byte, and report the stuck line without probing.
    Wait 30 s for the home network at boot (some routers turn away the first
    joins), and retry it from setup mode every 30 s, or every 2 min while
    someone is connected to the setup network, instead of never while a
    phone sits on the setup page.
    [main.cpp, pn532.cpp, pn532.h, reader.cpp]
2026-10-21 README: when to use the PN532 in HSU mode; SPI mode is not supported; status update
2026-10-21 Optional SSD1306/SH1106 OLED: active printer and slot, last scan's filament and status
2026-10-21 Display: filament name in the top band, printer and slot at the bottom
2026-10-22 CYD (ESP32-2432S028) touch screen support
    - New `cyd` build: the esp32dev firmware with the CYD's screen, PN532 HSU
    on CN1 (RX 27 / TX 22) and the blue LED as defaults. esp32dev also
    carries the screen (LovyanGFX 1.2.7), picked under Settings > Display:
    "cyd" (ILI9341) or "cyd-st7789" (the version that drew mirrored).
    - Screen: printer in the header (tap: next printer), filament colour
    swatch, material, brand, Spoolman spool, colour, nozzle temperature and
    status; bottom row sets the fixed slot; a scan waiting for a slot gets
    four buttons to put it there. Touch is bit-banged XPT2046 (LovyanGFX's
    driver read a fixed axis); its axes are swapped in landscape.
    - Settings save erase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
    [config.cpp, config.h, display.cpp, display.h, main.cpp, tft.cpp, tft.h]
2026-10-22 README: CYD slot picking from the touch screen tested
2026-10-22 Rename the project to LaneTag
    The reader is meant for more than Flashforge printers, so the project,
    web page and device names drop the zmod prefix: hostname lanetag-xxxx,
    setup network lanetag-setup-xxxx (password lanetag1). Settings move to
    the "lanetag" NVS namespace; saved settings from zmod_esp32-nfc firmware
    are copied over on first start, so updated boards keep their setup.
2026-10-22 Snapmaker U1 (Extended firmware) support
    New printer model "Snapmaker U1" with the "Extended firmware" method: a scan
    is posted to Klipper's filament_detect/set (as OpenRFID does), so the head
    takes it as its own RFID read and SpoolLink matches the UID in Spoolman.
    Tags naming a Spoolman spool are bound with SET_SPOOL_ID. U1 readers are
    always fixed to a head (no Ask) on the web page, button and CYD screen.
    [config.cpp, config.h, main.cpp, printers.cpp, tft.cpp, web.cpp]
2026-10-22 Display: say what answers on the I2C pins when the OLED does not
2026-10-23 platformio: ESP32-C6 env (pioarduino platform)
    Arduino core 2.x has no C6 support, so this env alone uses pioarduino's
    platform (Arduino core 3.x).
2026-10-23 More printers: Bambu, Creality, Anycubic, Qidi, Klipper, AD5M, U1 stock
    New printer models, each with its own method:
    - Bambu Lab (LAN mode): ams_filament_setting over the printer's MQTT
    broker; Generic preset ids, a Bambu tag's own preset; one AMS or the
    external spool per reader.
    - Creality K1 / K2 / Hi (CFS, stock firmware): modifyMaterial over
    Creality Print's WebSocket (port 9999), with the printer's material
    library entry; refuses busy printers and Creality RFID spools.
    - Anycubic Kobra (ACE, LAN mode): the signed LAN handshake for the MQTT
    login, then multiColorBox setInfo; the clock comes from NTP, else the
    printer's Date header.
    - Qidi Plus4 / Q2 / Max4 (Box, stock firmw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
    [anycubic.cpp, anycubic.h, bambu.cpp, bambu.h, config.cpp, config.h, creality.cpp, creality.h]
2026-10-23 Lane data: count lanes from lane_data too
    A printer with a filament changer feeds several lanes into one extruder
    (an AD5X's IFS: four lanes, one extruder), so counting extruders alone
    offered only T0. A printer now has as many lanes as it has extruders or
    as its lane_data already lists, whichever is more. Spoolman's active
    spool is set only on a printer with a single lane; with more, which lane
    prints is not known here.
    Tested on a Zmod AD5X (4 lanes, T2 written, active spool untouched), a
    Zmod Creator 5 (4) and an FLSUN T1 (1).
2026-10-23 README: drop the Zmod overview, printer model + method in the methods table
2026-10-23 README: PN532 HSU is tested on the ESP32-C3 too
2026-10-23 README: ESP32-C6 board, default pins and build
2026-10-23 README: ESP32-C6 builds without warnings too
2026-10-23 Find printers on the network from the Printers tab
    A background search over the reader's /24: Flashforge's UDP discovery
    (stock firmware, product ID -> model, serial filled in), Bambu SSDP
    announcements on port 2021, and a TCP sweep for Moonraker (7125),
    Creality's WebSocket (9999) and Anycubic's LAN handshake (18910).
    Moonraker printers are classified from Klipper's object list (Zmod
    AD5X / Creator 5 / AD5M and zmod_nfc, U1 Extended or stock, Qidi Box,
    Happy Hare, AFC, else lane data). Hosts that do not answer the first
    quick pass get a slower second one (lwIP's small ARP table drops some).
    Found printers stream in with an Add button that fills a new card.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
2026-10-26 Spoolman as a target: a stand-alone reader for Spoolman
    A new "Spoolman (no printer)" entry talks to Spoolman's REST API
    (port 7912) directly, with zmod_nfc's matching rules: the spool ID on
    the tag, else the tag's UID in the spool's card_uids (or nfc_id), else
    the one spool with the tag's brand, material and color (the UID is then
    bound to it), else a new spool (optional, on by default) reusing an
    exactly matching vendor and filament. An optional location is set on
    every scanned spool; the reply names the spool and its weight left.
    The spool list is parsed off an HTTP/1.0 stream through a filter, so
    large lists fit on a C3. Find printers also looks for Spoolman on 7912.
    Tested on the ESP32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
2026-10-26 README: lane data is tested on real Klipper printers
2026-10-26 Report scans to Spoolman's tag scanning
    Spoolman 0.27 takes scans from readers (POST /api/v1/tag/scan) and a
    paired browser opens the scanned spool. A new setting (Settings >
    Spoolman tag scanning) reports every scan there before it goes to the
    active printer, with the reader's name as its id, the tag format and
    the raw tag contents. The Spoolman target uses Spoolman's own tag links
    as well and links tags into them as it finds or adds spools (keeping
    card_uids for the printers), then reports the scan again so the page
    shows the right spool. The reader's name no longer says LaneTag twice
    when the hostname already does.
    Tested on the ESP32-C3 against Spoolman 0.27.0.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
    [config.cpp, config.h, main.cpp, printers.cpp, spoolman.cpp, spoolman.h]
2026-10-26 AFC: optional next-lane mode; 3 s scan hold-off
    AFC printers can send a tag's Spoolman spool to whichever lane is loaded
    next (SET_NEXT_SPOOL_ID) instead of a fixed or picked lane; tags without
    a spool ID, or AFC without Spoolman, still go to the slot (issue #1).
    After a whole read the reader rests 3 seconds, so a partial re-read as
    the spool is lifted off or put back cannot replace a good scan. "Read
    the tag again" skips the wait.
    [app.h, config.cpp, config.h, main.cpp, printers.cpp, printers.h, web.cpp]
2026-10-26 Optional deep sleep and RGB / WS2812 LED (untested on hardware)
    Sleep (Settings > Sleep after minutes unused, default 0 = off): after that
    long without a scan, button press, touch or page action, the PN532 / RC522
    power down, screen, LED and Wi-Fi switch off and the board deep-sleeps
    until the slot button wakes it. Saving refuses a button pin that cannot
    wake the board (C3 GPIO 0-5, C6 0-7, S3 0-21, ESP32 RTC pins).
    LED type (Settings > LED): single LED as before, an RGB LED on three pins
    or one WS2812. Colors: read blue, success green, failure red, waiting
    yellow, setup access point purple. Saved settings without a type load as
    a single LED; new CYD setups default to its RGB LED.
    Co-Autho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
    [app.h, config.cpp, config.h, display.cpp, display.h, feedback.cpp, feedback.h, main.cpp]
2026-10-26 Sleep: timer starts once on the network; no all-pin hold on the C3/C6
    Tested on a C3 SuperMini (button on GPIO 1): sleeps, wakes on the button,
    rejoins Wi-Fi in ~20 s and finds the PN532 again. The timer counted from
    power-on, so a slow Wi-Fi join left little time awake; it now starts at the
    end of setup. gpio_deep_sleep_hold_en() held every pin through the sleep;
    the pad keeps its pull-up without it (as in Espressif's deep_sleep example).
    README: after a wake, USB flashing fails until a power cycle.
    [main.cpp, sleep.cpp]
2026-10-27 Waveshare ESP32-C6-LCD-1.47: esp32-c6-lcd build with its screen
    New env esp32-c6-lcd (HAS_TFT, BOARD_C6_LCD147): the board's 172x320
    ST7789 through the TFT code in a compact landscape layout without touch,
    PN532 on HSU (header TX/RX) and the WS2812 on GPIO 8 as defaults. The
    screen owns GPIO 6/7/14/15/21/22 and the C6's only SPI bus, so SPI readers
    and reader pins on screen pins are refused, and stored reader pins on
    screen pins (as the plain esp32-c6 firmware saves them) are dropped on
    load: I2C on 6/7 there crash-looped the IDF I2C master interrupt.
    The PN532 stuck-line check and the display's held-low hint read the pins
    with gpio_get_level: on Arduino core 3 digitalRead of a pin the I2C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
    [config.cpp, display.cpp, display.h, pn532.cpp, tft.cpp, tft.h]
2026-10-27 Scan screens: the matched spool's name instead of the tag's
    When the printer (zmod_nfc, Spoolman, Happy Hare, AFC) reports the spool
    it found, the TFT and OLED show its name, with the tag's brand moved to
    the brand line when the name starts with it.
2026-10-27 Screens: scroll a filament name too long for its line
    The TFT scrolls the scan's name through a sprite when it fits neither
    title font; the OLED scrolls a title that fits no font, sending only the
    top two tile rows, and its scroll frames neither wake the screen nor
    reset its off timer. Both pause 2 s at the start of each round.
    [display.cpp, display.h, tft.cpp, tft.h]
2026-10-27 16x2 I2C character LCD (HD44780 + PCF8574 backpack) as a display type
    New "lcd1602" screen: a small 4-bit driver over the backpack, no library;
    the OLED's screens in two rows of 16 with scrolling for long rows; 100 kHz
    bus, 0x27/0x3F addresses in Settings, backlight off on screen sleep.
    Untested on hardware.
2026-10-28 LCD: RS/data settle before the EN pulse; report missed I2C writes in Settings
    [display.cpp, display.h, lcd1602.cpp, lcd1602.h]
2026-10-28 ESP32-C5 and Waveshare ESP32-C5-LCD-1.47 support; web UI screenshots
    New env esp32-c5 on pioarduino 55.03.31 (Arduino core 3.3, the first with
    the C5) with C5 pin defaults and wake pins (GPIO 0-6). New env esp32-c5-lcd
    for the Waveshare ESP32-C5-LCD-1.47: the same 172x320 ST7789 as the C6
    board on other pins (SCLK 7, MOSI 6, CS 23, DC 24, RST 26, BL 10), PN532
    HSU on the header's RXD/TXD (GPIO 12/11), WS2812 on 8. BOARD_C6_LCD147 is
    now BOARD_LCD147 for both boards; the screen pins follow the chip. The C5
    screen build needs LovyanGFX 1.2.33 (1.2.7 has no C5 GPIO support); the
    other envs keep 1.2.7.
    Tested on a Waveshare ESP32-C5-LCD-1.47: screen, PN532 (HSU) and a
    Creality tag scan into slo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
2026-10-29 Web page: send the AFC next-lane setting on Save
    The Save handler built its own field list and left out next_lane, so
    "Go to the next lane loaded" reverted to "Go to the slot above" (#1).
2026-10-29 FF_NFC method (zmod_nfc is now FF_NFC, on Zmod and Kiln OS)
    Method ff_nfc (saved "zmod_nfc" configs still load as it). Calls go to
    /printer/ff_nfc/*, falling back to /printer/zmod_nfc/* on a 404 for printers
    not moved over yet, remembered per printer. Discovery also finds Kiln OS
    AD5X printers with FF_NFC. Lane data keys ff_nfc_name/ff_nfc_uid.
2026-10-29 Klipper methods: find tags linked to a spool in Spoolman by their UID
    A tag only linked to its spool in Spoolman (no spool ID written on it)
    went nowhere with AFC, and Happy Hare / lane data used only its filament
    data (#1). Tags without a spool ID are now looked up in the Spoolman that
    Moonraker uses (/server/config): Spoolman 0.27's own tag links via
    /spool?tag=, else Card UIDs / nfc_id in the spool list (older Spoolman
    ignores ?tag= and lists every spool, which the same check covers). A
    "localhost" Spoolman address is taken as the printer's host.
    Tested on the ESP32-C5-LCD with a real tag against a fake AFC Moonraker:
    native tag link (real Spoolman 0.27) in lane and next-lane mode, Card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
2026-10-29 Versioned builds, GitHub releases and an update check on the web page
    The firmware's version is now `git describe` (v0.2.0 on a release tag,
    v0.2.0-3-gabc1234 after it, -dirty with local changes) instead of a fixed
    "0.1.0": tools/version.py writes it with the board (PlatformIO env) into a
    generated lanetag_version.h, rewritten only when it changes. /api/status
    reports "board"; Settings > Firmware shows "Version v0.2.0 · esp32-c3 build".
    Releases: pushing a v* tag runs .github/workflows/release.yml, which builds
    every board with tools/release.py and attaches per board an OTA file
    (lanetag-<version>-<board>.bin) and a factory image for USB at 0x0
    (-factory.bin, bootloader + partitions + app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
    [app.h, main.cpp, version.h, web.cpp]
2026-10-31 README: link the parts list at projects.die-hard.net/gear
2026-11-01 Logo on the web page and a start-up screen on every display
    Web page: the spool mark in the header, the full logo above the tabs,
    and the printer method notes moved below the Save button, one paragraph
    per method.
    Screens: the CYD and the 1.47" C6/C5 screens show the full logo (a
    300x118 PNG from docs/logo/make_splash.py) with the version for 3 s at
    power-on; the OLEDs show "LaneTag" with a spool icon, the 1602 LCD
    "LaneTag" between two spool characters. A touch or scan skips it, and
    it is left out after a wake from deep sleep. Settings > Display >
    "Logo at start-up" turns it off (display.boot_logo).
    [config.cpp, display.cpp, display.h, lcd1602.cpp, lcd1602.h, tft.cpp]
2026-11-01 Check for updates button that installs a release from GitHub
    Settings > Firmware no longer asks GitHub on page load: a "Check for
    updates" button does (from the browser, as before). When a newer release
    has a file for this board, the button turns into "Install update", and
    the reader downloads that file from GitHub itself (POST /api/ota, progress
    on GET /api/ota): HTTPS with GitHub's redirect followed, written straight
    into the OTA slot, checked against the release's SHA-256 digest, then a
    restart. Only this board's lanetag-<version>-<board>.bin from a LaneTag
    release is accepted. The manual upload stays, now below the button, and
    the card links the repo and its releases for downloading by h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
    [ota.cpp, ota.h, web.cpp]
2026-11-07 ideaspark ESP32 1.9" LCD: board env with its 170x320 ST7789 screen
    New ideaspark-lcd19 env (the esp32dev firmware with BOARD_LCD19): screen
    type "lcd19" on VSPI (SCLK 18, MOSI 23, CS 15, DC 2, RST 4, backlight 32),
    PN532 in HSU mode on GPIO 16/17 by default, no LED (GPIO 2 is the screen's),
    SPI readers refused. Settings saved by the plain esp32dev firmware drop
    reader and LED pins that are screen pins. Added to the release builds.
2026-11-07 ideaspark ESP32 1.14" LCD: board env and a layout for 135-row screens
    New ideaspark-lcd114 env (BOARD_LCD114, screen type "lcd114"): the same
    pins as the 1.9" board with a 135x240 ST7789 (offset 52/40). Screens under
    160 rows get a tighter layout: smaller header and slot row, 6 px margin,
    the setup values lined up after their labels, and the start-up logo
    scaled to fit. On such a screen the Wi-Fi error line scrolls when it does
    not fit. The setup screen now says "browse to" instead of "then open".
    README covers both ideaspark boards (RX2/TX2 for the PN532, free pins).
    [config.cpp, display.cpp, display.h, tft.cpp, tft.h]
2026-11-07 Wi-Fi: join the strongest access point and skip weak ones
    On a mesh (several access points with one name) the ESP32's default fast
    scan joins the first match from channel 1 up. A far node there kept
    turning a reader away with AUTH_EXPIRE, and the reader retried it forever
    while a near node would have let it in. Now every channel is scanned, the
    strongest access point is taken, and access points more than 10 dB below
    the strongest one heard at start-up (rescanned before each retry from the
    setup network) are left out.
    [main.cpp]
2026-11-08 README: table of the boards and screens tested on real hardware
2026-11-08 README: every tested board has run with a PN532
2026-11-12 Logo: printable multi-colour 3D plaque (.blend + OBJ/MTL for OrcaSlicer)
    logo3d_flatten.py paints the SVG into non-overlapping per-colour regions
    (fills, strokes, clip paths, transforms), adds a backing plate and
    triangulates watertight prisms. logo3d_blender.py builds the .blend and
    exports a Z-up, millimetre OBJ whose MTL carries the exact sRGB colours.
    Output: 100 x 97 x 2.6 mm, 1.6 mm base plus a 1.0 mm colour layer.
    [lanetag-logo-stacked-dark.blend, lanetag-logo-stacked-dark.obj]
2026-11-13 Decode OpenTag3D and TigerTag tags on the reader
    Ported from FF_NFC's decoders, so every printer method (not only FF_NFC)
    gets material, color and temperatures from these tags. TigerTag ids are
    looked up in src/tigertag_db.h, generated by tools/tigertag_tables.py
    from FF_NFC's offline copies of TigerTag's tables.
2026-11-13 Logo: print files (4-color plaque, inlay OBJ/STL sets); ignore Blender .blend1 backups
    [lanetag-icon-inlay-facedown.obj, lanetag-icon-inlay.obj, lanetag-icon-orange.stl, lanetag-icon-red.stl, lanetag-icon-white.stl, lanetag-inlays.blend, lanetag-logo-4color-B.blend, lanetag-logo-4color-B.obj]
2026-11-14 Two Waveshare C6 boards, voice commands, cleaner slot rows
    New boards:
    - esp32-c6-touch-lcd: Waveshare ESP32-C6-Touch-LCD-1.47. JD9853 panel
    (Waveshare's init list, BGR order) and AXS5106L touch on I2C 18/19,
    polled with a stop before each read (it NAKs a repeated start).
    - esp32-c6-lcd169: Waveshare ESP32-C6-LCD-1.69, 240x280 ST7789 shown as
    280x240, inset from the rounded corners; GPIO 15 held high for battery
    power. Uses the 8 MB partition layout.
    Voice commands (esp32-c6-lcd169): hold PWR, say Next/Previous printer,
    Lane 1-4 or Ask. Matched on the board against the user's own takes
    (fixed-point MFCC + DTW, no server); trained from Settings > Voice
    commands, up to 6 takes per com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
    [app.h, config.cpp, config.h, display.cpp, display.h, es8311.cpp, es8311.h, es8311_reg.h]
2026-11-14 release.py: chips for the esp32-c6-touch-lcd and esp32-c6-lcd169 builds
